Leonard-ssj/simon-dice-por-voz/componentes_kit.md

# Componentes del kit

- ESP32-S3 N16R8 (placa principal)
- Pantalla OLED SSD1306 0.91" (I2C)
- Micrófono digital INMP441 (I2S, pines SD/WS/SCK/LR)
- Amplificador MAX98357A (I2S)
- Bocina pasiva 4Ω 3W
- Botón SW1
- Botón SW2
- LED RGB integrado
- Conexión USB-C (alimentación y serial)
