Leonard-ssj/simon-dice-por-voz/(commit log)

2026-03-17 feat: narrador TTS, VAD rápido y UI de micrófono en tiempo real
    Simulador PC:
    - Elimina Whisper/micrófono de Python — el browser maneja todo el reconocimiento de voz
    - Al conectar el panel: TTS narra bienvenida y reglas completas
    - Estados parlantes: SHOWING ("Mira y escucha"), LISTENING ("Tu turno"),
    EVALUATING (log "Procesando..." en terminal y panel), GAME_OVER (dice puntuación),
    WRONG/TIMEOUT ("Di empieza para intentar de nuevo"), LEVEL_UP ("Correcto. Nivel N.")
    - main.py muestra instrucciones explícitas al iniciar: "Selecciona Simulador WebSocket"
    VAD del browser (useWhisperWASM):
    - VAD_THRESHOLD: 0.025 → 0.015 (mic menos sensible antes no capturaba)
    - BLOQUES_CONFIRMAR: 2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
    [main.py, ws_server.py]
2026-03-17 fix: badge solo en LISTENING, mic abierto real, modelo tiny, narración desbloqueada
    - whisper-tiny (q8, ~40MB) en vez de whisper-small (~125MB): descarga 3x más rápida
    - Badge "Habla ahora" solo aparece cuando el mic está REALMENTE abierto (getUserMedia éxito),
    no al instante de llamar escuchar(). Nuevo estado micAbierto en useWhisperWASM.
    - Badge y log "Escuchando..." solo visibles cuando el juego está en estado LISTENING.
    En IDLE/GAMEOVER el bucle escucha en segundo plano sin spam visual ni de log.
    - Cooldown 3s en estados no-LISTENING (vs 1.5s en LISTENING) para reducir alucinaciones.
    - Narración Python: bloquear=False en todas las frases del TTS. Evita deadlock cuando
    dos hi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
    [main.py]
2026-03-17 feat: orquestador de ventanas de silencio + whisper-small + contexto expandido
    Orquestador (silencioHastaRef):
    - Al conectar WebSocket: mic silenciado 8s (TTS narra bienvenida ~7s)
    - RESULT:CORRECT: silenciado 2.5s (TTS "Correcto. Nivel N.")
    - RESULT:WRONG/TIMEOUT: silenciado 4.5s (TTS "Incorrecto/Tiempo agotado...")
    - GAMEOVER: silenciado 7s (TTS narra puntuación e instrucciones)
    - STATE:LISTENING: limpia ventana de silencio — escucha inmediata
    - STATE:SHOWING: resetea ultimaDeteccion/ultimoTextoWhisper/ultimoResultado
    - Transcripciones y log de voz solo visibles en estado LISTENING
    Modelo Whisper:
    - Vuelve a whisper-small (q8, ~125MB) — mejor precisión para español
    - initial_prompt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
2026-03-17 fix: reemplazar pyttsx3.runAndWait() con PowerShell SAPI para TTS confiable
    pyttsx3.runAndWait() se bloquea silenciosamente en hilos de Windows
    (bug conocido con COM/STA threading). El narrador nunca hablaba.
    Nuevo enfoque:
    - pyttsx3 se usa SOLO para enumerar y detectar el nombre de la voz española
    (sin llamar a runAndWait — solo engine.getProperty("voices"))
    - Cada frase se habla vía subprocess PowerShell + System.Speech.SpeechSynthesizer
    - PowerShell crea un proceso fresco por frase → garantizado en Windows 11
    - Rate = -1 (ligeramente lento, más natural que el default)
    - La API pública (decir, decir_color, inicializar_tts, esperar_tts) no cambia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
2026-03-17 Fix LEDs, mic status badge, reiniciar button y estado procesando
    - ws_server.py: on_comando corre en hilo daemon para no bloquear el event
    loop de asyncio — arregla que los LEDs no se animaran correctamente
    - audio_pc.py: Rate=0 en SAPI (velocidad natural); sugerencia de voces
    neurales en log cuando no hay voz en español
    - useWhisperWASM.ts: nuevo estado `procesando` (true entre cierre del mic
    y resultado de Whisper); `micAbierto` solo se activa tras getUserMedia
    - useWebSocket.ts + useWebSerial.ts: función `reiniciar`, expo de
    whisperProcesando, whisperMicAbierto, whisperGrabando, whisperNivelMic
    - ConnectionPanel.tsx: badge de 4 niveles (Escuchando/Detectando voz/
    Procesando/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
    [ws_server.py]
2026-03-18 Fix timing/workflow: mute windows, timeout pause, VAD params
    Problema principal: el mic abría durante el TTS causando alucinaciones de
    Whisper (ej: "Vista 0, Pontos." en portugués), y el timer del juego
    expiraba mientras Whisper hacía inferencia.
    useWhisperWASM.ts:
    - SILENCIO_TOLERADO 500→800ms (no corta palabras largas)
    - DURACION_MINIMA 150→300ms (filtra fragmentos de ruido)
    - TIMEOUT_GRABACION 8000→12000ms (más margen para hablar)
    - escuchar(onProcesandoInicio?) — callback opcional llamado justo
    antes de postMessage al worker, para que el caller pause el timer
    useWebSocket.ts:
    - onopen mute: 8s→20s (cubre los ~18s de la bienvenida TTS)
    - Guarda CONNECTING en conectar()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
    [main.py]
2026-03-18 Fix: mic background IDLE visible + gap 3s→500ms + badge "Di empieza"
    Problema: el usuario nunca sabía cuándo decir "empieza" porque:
    1. El mic se abría silenciosamente en IDLE (ningún badge)
    2. El bucleVoz esperaba 3s entre ciclos → ventana ciega de 3s
    Fixes:
    - bucleVoz useWebSocket: espera tras escuchar() en IDLE/GAMEOVER
    3000ms → 500ms (casi continuo, ≤500ms de mic cerrado entre intentos)
    - bucleVoz useWebSerial: diferencia LISTENING(1500ms) vs IDLE(500ms)
    - micAbiertoEnBackground: nuevo prop en ambos hooks — true cuando el mic
    está abierto en IDLE/GAMEOVER (background listening)
    - ConnectionPanel: badge sutil "Di «empieza»" (gris pulsante) cuando
    micAbiertoEnBa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
2026-03-18 refactor(web-panel): reemplazar VAD continuo por Push-to-Talk (PTT)
    El micrófono ahora solo se abre cuando el usuario mantiene presionada
    la barra espaciadora o el botón «Mantén para hablar» en el panel.
    Elimina el bucle VAD automático, las ventanas de silencio y las
    alucinaciones de Whisper al capturar audio del sintetizador de voz.
    - useWhisperWASM: nuevo modo "ptt" + finalizarGrabacion() via terminarRef
    - useWebSocket: quitar bucleVoz/silencioHastaRef, agregar spacebar PTT
    - useWebSerial: mismo refactor PTT que WebSocket
    - ConnectionPanel: botón PTT con estados visual (grabando/procesando)
    - page.tsx: pasar iniciarPTT/finalizarPTT/puedoHablar al panel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
2026-03-18 feat: integrar Whisper local en Python como motor de voz preferido
    El servidor Python ahora carga Whisper al arrancar y transcribe el audio
    directamente. El browser captura PCM Float32 16kHz con AudioContext y lo
    envía como frame binario WebSocket; Python devuelve el texto y comando.
    El browser Whisper WASM se mantiene como fallback automático si Python
    no tiene Whisper disponible. Web Serial sigue usando WASM sin cambios.
    - ws_server.py: cargar_whisper(), transcribir(), handler de frames binarios
    - main.py: _on_audio_recibido() con pausar/reanudar_timeout, ws.on_audio
    - config_test.py: WHISPER_MODEL="base", TIMEOUT_RESPUESTA=15000ms
    - requirements_test.txt: agregar openai-whisper
    - useWe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
2026-03-18 fix: corregir timeout + agregar modelo small y contexto a Whisper local
    Race condition corregida: el browser envía PTT_INICIO (JSON) justo antes
    del audio binario. Python llama pausar_timeout() en el hilo del WebSocket
    (asyncio), antes de spawnear el hilo de Whisper, eliminando la ventana
    donde tick() podía disparar TIMEOUT durante la inferencia.
    - config_test.py: WHISPER_MODEL="small", TIMEOUT_RESPUESTA=30000ms
    - ws_server.py: on_pausar_timeout callback, manejo de "control/PTT_INICIO",
    initial_prompt con vocabulario del juego (mismo que el browser)
    - main.py: registrar on_pausar_timeout, quitar pausar_timeout de on_audio_recibido
    - useWebSocket.ts: enviar PTT_INICIO al inicio de PTT en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
    [main.py, ws_server.py]
2026-03-18 fix: READY per-cliente + info dispositivos en panel
    - ws_server.py: enviar READY directamente a cada cliente al conectar
    (no via cola — resuelve el bug donde enviar_ready() se llamaba sin clientes)
    Incluye dispositivoMic, dispositivoSpeaker, whisperModelo en el mensaje
    - main.py: eliminar ws.enviar_ready() (ahora lo hace ws_server por cliente)
    - useWebSocket.ts: eliminar effect con race condition (conectado && !whisperLocalActivo)
    Cargar WASM solo desde el handler del READY cuando whisperDisponible=false
    Guardar info de dispositivos en el estado
    - types/game.ts: agregar dispositivoMic, dispositivoSpeaker, whisperModelo
    - useWebSerial.ts: inicializar nuevos campos en ESTADO_INICIAL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
    [main.py, ws_server.py]
2026-03-18 fix: PTT atascado + voz española en TTS
    - main.py: enviar_voz("","DESCONOCIDO") aunque audio sea muy corto
    (antes el browser quedaba atascado en "Procesando..." sin fin)
    - useWebSocket.ts: limpiar rawProcesando/rawGrabando/escuchandoRef
    al recibir "result" o "gameover" (defensa contra cualquier edge case)
    - audio_pc.py: corregir selección de voz en PowerShell
    SelectVoice("Sabina") en vez del nombre completo con paréntesis/guiones
    que fallaba silenciosamente y caía al default inglés
    Rate -1 para habla ligeramente más lenta y clara en español
    [main.py]
2026-03-18 feat: voz neural mexicana (edge-tts) + hint PTT en panel
    - audio_pc.py: agregar _hablar_edge() con es-MX-DaliaNeural via edge-tts
    + pygame para reproducción MP3; fallback a PowerShell SAPI si falla
    - requirements_test.txt: agregar edge-tts y pygame
    - GameStatus.tsx: mostrar "Presiona ESPACIO o el botón para hablar"
    cuando estado=LISTENING y no está grabando
    - page.tsx: pasar grabando={whisperGrabando || whisperTranscribiendo}
2026-03-18 fix: asyncio loop persistente + narración botón + log scroll + docs completas
    - audio_pc.py: loop asyncio persistente en hilo TTS — elimina RuntimeError
    "Event loop is closed" de ProactorBasePipeTransport en Windows Python 3.10
    Siempre detectar voz SAPI para fallback aunque edge-tts esté disponible
    - main.py: LISTENING narrador dice "Tu turno. Presiona el botón para hablar."
    - LogConsole.tsx: auto-scroll con scrollTop directo (inmediato, no smooth)
    - docs/arquitectura.md: reescritura completa — modo dual Whisper, PTT,
    edge-tts, protocolo WebSocket actualizado
    - docs/setup.md: reescritura completa — instalación, flujo PTT, tabla Whisper,
    troubleshooting con errores conocido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
    [main.py]
2026-03-18 feat: TTS correcto + layout 3 col + log rediseñado + secuencia compacta
    - main.py: narrador dice "Correcto." al acertar; bienvenida incluye instrucción
    de presionar el botón/espacio + "di empieza"; elimina duplicado en _on_nivel
    - LogConsole: rediseño visual — header con icono Terminal, colores más vivos,
    dot por tipo, fondo sutil por fila, filtros compactos, borde indigo con glow
    - page.tsx: layout 3 columnas (LEDs+Seq | Estado+Score | Log full-height)
    - SequenceDisplay: celdas reducidas w-9→w-6, gap 2→1.5, texto 10px→9px
    - ConnectionPanel: botón PTT más grande (px-4 py-2 text-sm), glow al grabar,
    efecto scale-95 al presionar
    - docs: arquitectura y setup actualizados co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
    [main.py]
2026-03-18 fix(layout): rediseño 2 col + botón desconectar en primera fila
    - page.tsx: layout 2 columnas (LEDs+Seq izq | Estado+Score+Log der)
    Log ocupa todo el alto restante — ya no queda espacio vacío
    Estado y Score en fila horizontal dentro de la columna derecha
    - ConnectionPanel: botón Conectar/Desconectar movido a la primera fila
    (estaba después de basis-full y caía a una tercera fila)
    - docs/arquitectura.md: diagramas Mermaid completos — sistema general,
    flujo PTT, TTS, ESP32 secuencia, Serial, máquina de estados
2026-03-18 feat(ui): TurnoTimer — countdown + referencia de comandos
    Nuevo componente en el espacio vacío debajo de Secuencia:
    - Estado LISTENING: temporizador regresivo 30s con barra de progreso
    coloreada (verde → amarillo → rojo), número grande, "¡Habla ahora!"
    cuando quedan ≤5s. Muestra el color esperado arriba.
    - Otros estados: tabla compacta de comandos de voz reconocidos
    (empieza, rojo, verde, azul, amarillo, repite, pausa, para)
    con sus variantes fonéticas — referencia rápida para el jugador.
2026-03-18 feat: timer delay post-TTS + log newest-first + stats sesión
    TurnoTimer:
    - Agrega startDelayMs (default 3500ms) — el countdown no arranca hasta
    que termina el TTS "Tu turno. Presiona el botón para hablar."
    - Mientras espera: muestra "—" gris + "Escucha las instrucciones..."
    - Al arrancar: countdown normal verde→amarillo→rojo
    LogConsole:
    - Newest siempre al tope (scrollTop=0 al llegar nuevo mensaje)
    - Usuario baja para ver historial; al alejarse del top aparece
    botón "Ver recientes" (flecha arriba) que vuelve al inicio
    - Rename "Ir al final" → "Ver recientes" con flecha hacia arriba
    SesionStats (nuevo componente):
    - Mejor nivel y puntaje de la sesión
    - Total de partidas ju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
2026-03-18 fix(log): overflow-anchor:none para newest-at-top confiable
    El browser tiene scroll anchoring por defecto: cuando se inserta un
    elemento arriba del viewport, aumenta scrollTop automáticamente para
    mantener el contenido viejo visible, ignorando nuestro scrollTop=0.
    Solución: overflow-anchor:none en el contenedor del log desactiva
    ese comportamiento — el scroll se queda en 0 y el nuevo mensaje
    aparece arriba siempre.
    También simplifica la animación de entrada (solo opacity, sin x)
    para evitar interferencia con el posicionamiento al insertar en top.
2026-03-18 fix(log): revertir a newest-at-bottom con auto-scroll confiable
    El enfoque newest-at-top falla por scroll anchoring del browser.
    El patrón correcto (usado en todos los logs/chats en tiempo real):
    - Render cronológico: oldest arriba, newest abajo (sin .reverse())
    - scrollTop = scrollHeight al llegar nuevo mensaje → newest siempre visible
    - Si usuario sube: auto-scroll pausa, aparece botón "Ver recientes" ↓
    - Click → scroll al fondo (newest) + auto-scroll reactiva
2026-03-18 docs(arquitectura): agregar sección Componentes UI y actualizar carpetas
    - Nueva sección con tabla de los 9 componentes del Web Panel
    (ConnectionPanel, LEDPanel, GameStatus, ScoreBoard, SequenceDisplay,
    LogConsole, TurnoTimer, SesionStats, HowToPlay)
    - Estructura de carpetas actualizada con TurnoTimer.tsx y SesionStats.tsx
2026-03-25 docs(simulador): README completo con reglas, estados, comandos y cronología
    - Reglas del juego y sistema de puntuación
    - Máquina de estados con diagrama ASCII
    - Cronología detallada de una partida
    - Tabla de comandos de voz con variantes fonéticas
    - Flujo PTT + Whisper con fallback WASM
    - Cascada TTS y frases del narrador
    - Protocolo WebSocket completo (mensajes entrada/salida)
    - Tabla de configuración (config_test.py)
2026-03-27 feat: PTT con Whisper Python local + fixes firmware Simon Dice
    - firmware/game_engine: pausarTimeout/reanudarTimeout para congelar
    el countdown mientras el browser transcribe via PTT
    - firmware/game_engine: fix static vars en _actualizarShowing → instance vars
    (evita bug con REPITE que reutilizaba estado de partida anterior)
    - firmware/game_engine: RESULT:CORRECT enviado en parcial y completo,
    STATE:LEVEL_UP + sonidoNuevoNivel en cada nivel superado,
    ledEfectoGameOver + sonidoGameOver en GAME_OVER
    - firmware/simon_dice: loop() lee línea cruda y despacha PTT_INICIO/PTT_FIN
    antes de parsear vocabulario
    - servidor_voz/main.py: servidor WS en :8766, solo voz — captura mic PC
    con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
    [config_voz.py, main.py]
2026-03-27 feat(hardware): OLED + botones PTT fisico + INMP441 + I2S speaker
    Firmware (nuevo hardware del kit MRD085A):
    - oled_display.h/cpp: display SSD1306 0.91" I2C — muestra estado,
    nivel, puntuacion y color esperado en tiempo real
    - botones.h/cpp: SW1/SW2 (音量+/-) como botones PTT fisicos;
    presionar pausa el timeout, graba audio en PSRAM y al soltar
    envia base64 por Serial para que el browser transcriba con Whisper
    - sound_control: LEDC PWM reemplazado por I2S real (I2S_NUM_1)
    para el amplificador MAX98357A — tonos ahora suenan correctamente
    - audio_capture: nuevo modo PTT — buffer en PSRAM (10s max),
    audioCapturaLoop() no bloqueante, audioCapturaPararYEnviar()
    codifica a base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
    [main.py]
2026-03-27 docs: agregar diagramas Mermaid y actualizar arquitectura
    - Nuevo: diagrama_hardware_esp32.md — conexiones físicas kit MRD085A
    - Nuevo: diagrama_flujo_esp32.md — flujo completo ESP32 paso a paso (92 pasos)
    - Nuevo: diagrama_arquitectura_completa.md — tres modos lado a lado con comparativa
    - arquitectura.md actualizado: hardware OKYN→MRD085A, baud 115200→921600,
    protocolo Serial con BTN_INICIO/AUDIO:START/END, estructura de carpetas
    con botones.h/oled_display.h/servidor_voz/, tabla de modos PTT
2026-03-27 fix(leds): convertir LEDs a virtuales via Serial + actualizar docs
    Sin LEDs físicos en el kit MRD085A — los colores se muestran
    únicamente en el Web Panel (componente LEDPanel).
    - led_control.cpp: eliminar GPIO, enviar LED:COLOR / LED:OFF por Serial
    - led_control.h: eliminar PIN_LED_* defines, actualizar comentario
    - docs/diagrama_hardware_esp32.md: quitar subgraph GPIO_LED, agregar LEDs virtuales
    - docs/arquitectura.md: actualizar Kit MRD085A sin LEDs físicos
    - CLAUDE.md: renombrar OKYN-G5806 → MRD085A, quitar sección de LEDs físicos,
    actualizar pines con estimaciones y ⚠️ verificar
2026-03-27 docs: reescribir diagramas Mermaid — labels limpios sin backslash-n
    Diagramas completamente reescritos para ser legibles:
    - Eliminado %%{init htmlLabels:false}%% que causaba text literal \n
    - Labels cortos de una sola línea sin caracteres raros
    - diagrama_hardware_esp32.md: diagrama simple componente→bus, tabla de pines
    - diagrama_flujo_esp32.md: stateDiagram2 + flowchart simplificado + secuencia PTT + tabla OLED
    - diagrama_arquitectura_completa.md: 3 modos limpios + secuencia por modo + tabla protocolo
    - Tabla comparativa corregida: sin LEDs físicos, servidor_voz marcado como opcional
2026-03-27 fix(firmware): corregir specs ESP32-S3 N8R2 — 2MB PSRAM, buffer PTT 5s
    Kit real es OKYN-G5806 con N8R2 (8MB Flash, 2MB PSRAM), no N16R8.
    Reducir AUDIO_PTT_MAX de 10s a 5s para caber en 2MB PSRAM con margen.
2026-03-28 refactor(pines): centralizar todos los pines GPIO en pines.h
    Un solo archivo para cambiar si los pines del kit son diferentes.
    Los 4 headers individuales ahora importan pines.h.
2026-03-28 refactor(firmware): mover sketch a firmware/simon_dice/ (requerido por Arduino IDE)
    Arduino IDE requiere que el .ino esté en carpeta con el mismo nombre.
    Sin cambios funcionales — solo reubicación + fix mck_io_num en I2S.
2026-03-28 fix(firmware): agregar includes faltantes para compilar en IDF 5.5
    - vocabulario.h: #include <cstring> para strcmp
    - game_engine.cpp: #include <Arduino.h> para delay/millis/random
2026-04-06 retroceso hasta armar bien el hardware
2026-04-10 test hardware y circuito en protoboard
2026-04-14 avance en whisper y servidor pc para el mic y oled, rgb del esp32 fucionando algo bien con la logica del simon dice con el web panel
2026-04-16 docs actualiza, correccion de bugs y sincronizacion perfecta antes de integrar la bocina como el narrador
    [servidor.py, validador.py, ws_server.py]
2026-04-16 test para bocina ya con audios grabados pcm intentar probar
    [partitions.csv]
2026-04-16 correcion de test bocina
    [partitions.csv]
2026-04-16 Correcion de test bocina como analisis para integrar la bocina correctamente
    [partitions.csv]
2026-04-17 integracion de la bocina al juego simulador pc
    [partitions.csv]
2026-04-17 fix de panel oled web y creacion para venv del propio servidor de python.
    [config.py, proyecto.ino, serial_bridge.py, servidor.py]
